onebody/QiYun-LapTimer-Node/docs/3d/preview-plate.png

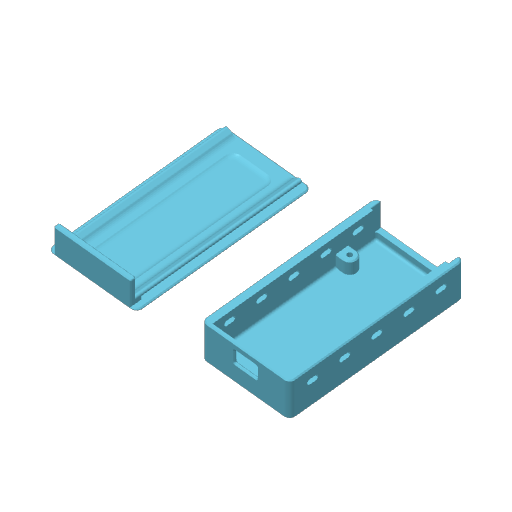
docs/3d/preview-plate.png
