onebody/QiYun-LapTimer-Node/docs/3d/case-base.stl

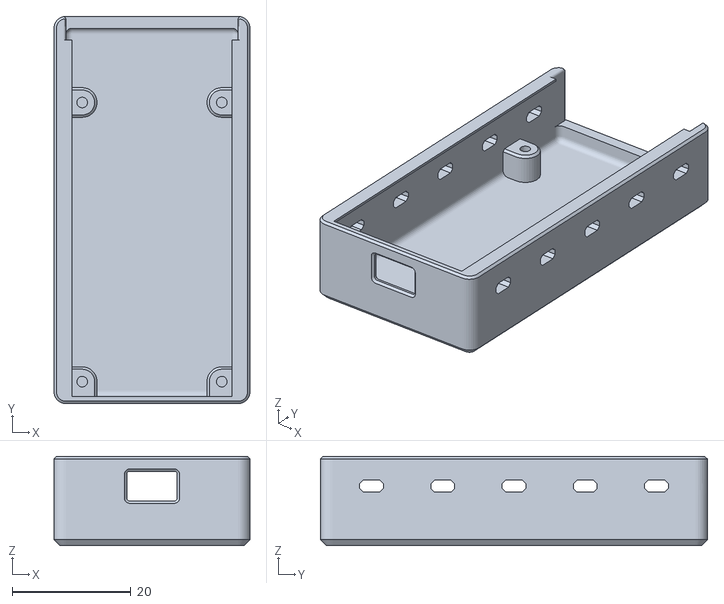
[picture p4: CAD file, 2026-10-22]
docs/3d/case-base.stl
33.0 x 65.2 x 15.0
