onebody/QiYun-LapTimer-Node/docs/3d/enclosure-bambu-studio.3mf

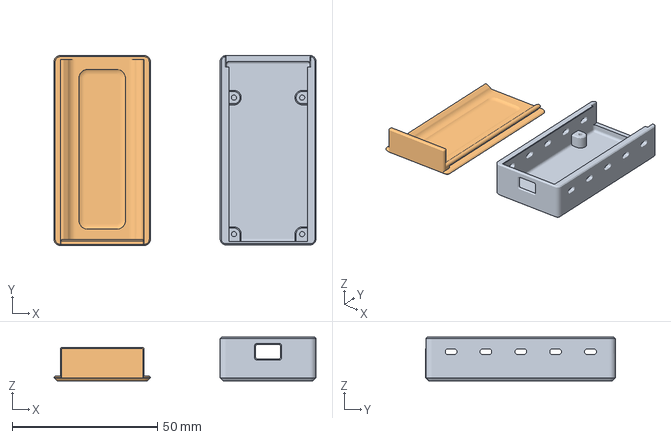
[picture p5: CAD file, 2026-10-22]
docs/3d/enclosure-bambu-studio.3mf
90.2 x 65.4 x 15.0 mm
外壳底座.stl
实体1.stl
