onebody/QiYun-LapTimer-Node/docs/3d/case-lid.stl

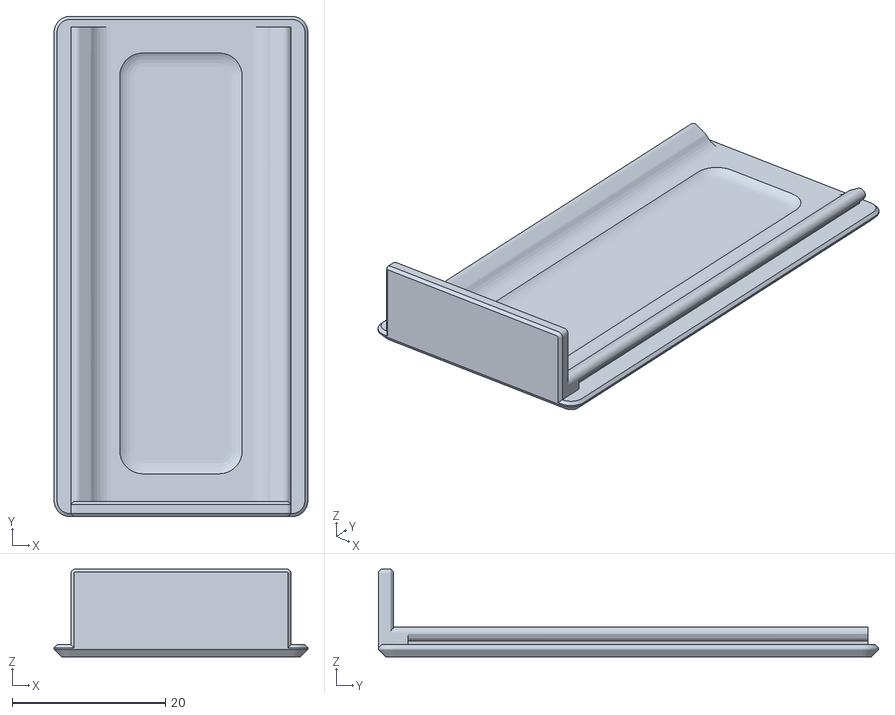
[picture p6: CAD file, 2026-10-22]
docs/3d/case-lid.stl
33.2 x 65.4 x 11.5
