onebody/QiYun-LapTimer-Node/docs/3d/assembly-render.jpg

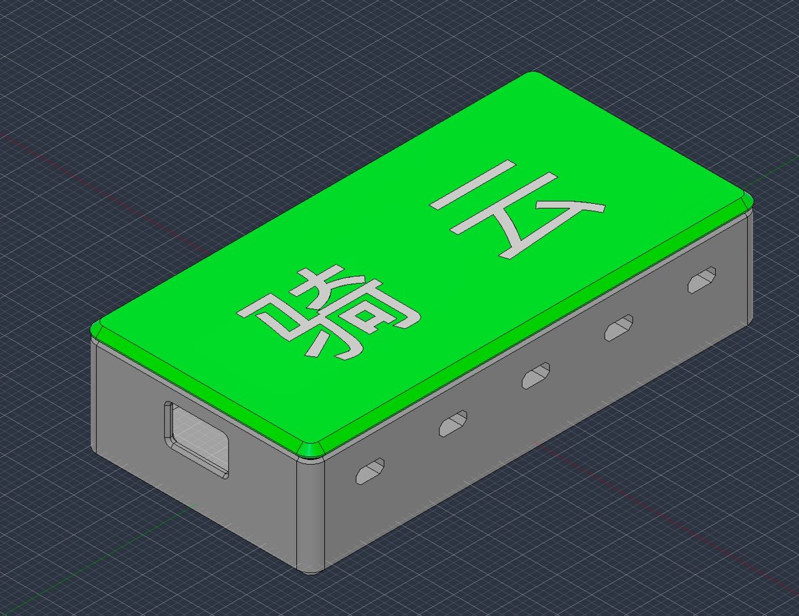
docs/3d/assembly-render.jpg
