onebody/QiYun-LapTimer-Node/docs/3d/printed-lid.jpg

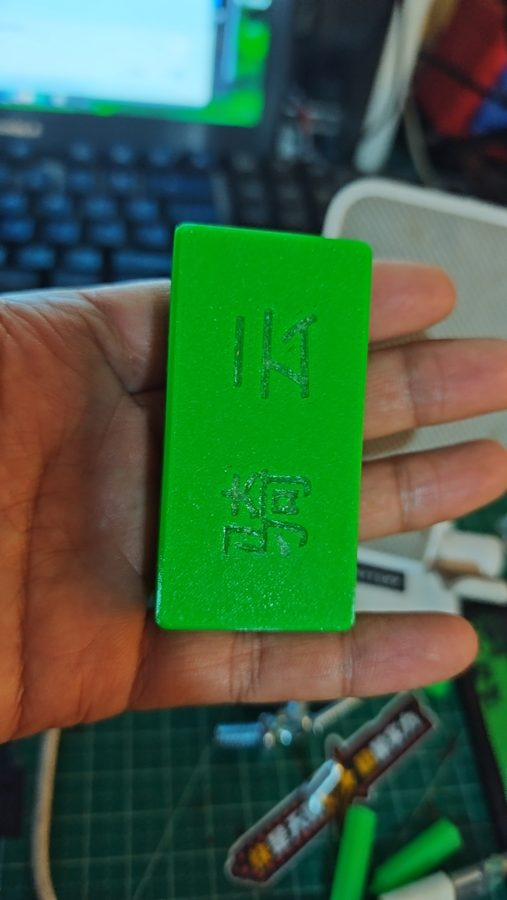
docs/3d/printed-lid.jpg
