onebody/QiYun-LapTimer-Node/(commit log)

2026-10-22 骑云 FPV 竞速计时系统：固件、Web 终端与完整文档
    ESP32 + RX5808 单节点 5.8GHz 圈速计时器。lib/ 为固件模块，data/ 为 LittleFS
    网页镜像，docs/ 为四份文档与外壳 3D 模型。
    基于 PhobosLT / RotorHazard 的 RSSI 峰值计时思路，面向国内场景定制：多芯片构建
    环境、2/5 寸机自适应、中文 Web UI 与自动校准向导、浏览器 TTS 播报、训练数据上云、
    固件与文件系统双通道 OTA。
2026-10-22 恢复 PlatformIO 项目库目录结构，修复固件无法编译
    lib/ 的 17 个源文件此前被平铺到目录根，PlatformIO 只识别 lib/<子目录>，
    builder.py 用 env.BuildSources() 手工接管编译，但这批目标拿不到 Arduino 核心
    与 libdeps 的头文件搜索路径， pio run -e esp32dev 在 #include <WiFi.h> /
    <ArduinoJson.h> 处直接 fatal error，仓库里的固件实际编不出来。
    改回一模块一目录（CONFIG / RX5808 / KALMAN / LAPTIMER / WEBSERVER / LED /
    BUZZER / BATTERY / DEBUG），删除 builder.py 与 [env] 的 extra_scripts。
    内容未改动，仅移动位置。
    实测 pio run -e esp32dev 通过：Flash 87.5 %（1 146 969 / 1 310 720 B）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
2026-10-22 文档补一节：Release 预编译镜像与 OTA 刷写
    新增 02 §3.4，说明免装工具链的升级路径：Releases 每次给固件 app（0x10000）
    与网页 LittleFS（0x290000）两个独立 bin，附 esptool 命令、SHA256 核对方法与
    /version 验证；同时写清两条限制——不含 bootloader.bin / partitions.bin，
    刷不亮全新空白模块；bin 只在 esp32dev 实测过，C3/S3/DOIT 请自行构建。
    03 §8 补发布侧同名小节（产物命名、tag 规则、gh release create 步骤），并更正
    一处错误描述：firmware.bin 是纯 app 镜像，不含 bootloader 与分区表，二者是同
    目录下的独立文件。mklittlefs 的 Apple Silicon 坑补上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
2026-10-22 新增 Web 页面计时操作图文指南
    四个页签的逐步截图操作手册，配 tools/mock_server.py 可在无 ESP32
    的环境下复现前端界面（截图即由它产出）。同时把校准向导第 3 步
    峰值恒为 -Infinity 的缺陷根因补进 03 §7 已知限制第 11 条。
2026-10-27 Add C5 UART RSSI receiver abstraction
2026-10-27 Refactor lap timer to use receiver interface
2026-10-27 Decouple lap timer from RX5808 hardware
2026-10-27 Add C5 UART host pin configuration
2026-10-27 Add S3-Zero and C5 UART build environments
2026-10-27 Expose fresh RSSI sample gating
2026-10-27 Gate lap updates on fresh C5 samples
2026-10-27 Mark fresh C5 protocol samples
2026-10-27 Process only fresh UART RSSI samples
2026-10-27 Document C5 UART digital RSSI adaptation
2026-10-27 Mark shared UART RSSI cache volatile
2026-10-27 Recover UART frequency after peer timeout
2026-10-27 Document new C5 UART build environments
2026-10-27 Add CI builds for C5 UART host variants
2026-10-27 Include receiver pin configuration explicitly
2026-10-27 Mark tune timestamp shared with timer core
2026-10-27 Preserve original polling cadence for timer compatibility
2026-10-27 Exclude unavailable unused ArduinoZip from C5 UART S3 builds
2026-10-27 Define chip macros expected by legacy pin configuration
2026-10-27 Set S3 chip macro for C5 UART DevKit profile
