onebody/QiYun-LapTimer-Node/(notices)

Notices in the files:
README.md:
License: MIT
